CJacobs8/motion-responsive-lightsabre/calculations/Lightsabre_Design_Calculations.pdf

## 1. Concept Selection:

### 1.1 LED Configuration:

L 1 m strip

m

LED N | 60 strip

### LED

1
N 2 strips

N 120 strips N

strip L

strip N
LED

//Total number of LEDs

### 1.2 WS2812B Data Requirement

### B 24 LED

### f 800 kHz data

s

5

### 3 10 fdata

B
LED tLED
//The time required to transmit the data for one LED

### 1.3 Time Required for the Complete LED Strip

### B 2880 LED N

LED B
Total | //The total number of bits transmitted to update all 120 LEDs

0,0036 s
fdata

B
Total tupdate | //The total transmission time
t | 0,05 ms reset | //WS2812B minimum reset (latch) time from the datasheet
t | 3,65 ms reset t

update t
strip | //Complete strip update including the reset time

### 1.4 Required Lighting Update Rate

f | 50 Hz required | //Assumption for the comparison

0,02 s
f
required

1
Trequired

100 18 Trequired

t
update ULED | % | //The percentage of the available update period used by the LED data transmission
t | 0,0164 s update T

required t
remaining

Conclusion: This means the LED data transmission occupies 18% of the 20 ms update period, leaving approximately 16.4 ms for other processing.:

### 1.5 Maximum Theoretical LED Update Rate

### 277,7778 Hz t

update

1
fmax_LED

### 1.6 Concept 1 - Raspberry Pi Pico 2 (RP2350)

### 1.6.1 Microcontroller processing speed:

f | 150 MHz CPU_1

### 4 Oct 2026 18:46:16 - Calcs App E - corrected_5.sm

1 / 15

s

9
6,6667 10 f
CPU_1

1
T
CPU_1

### 1.6.2 Available Processing Cycles per Lighting Update:

6
T 3 10 required f

CPU_1 C

Total_1 | cycles

### 1.6.3 Processing Cycles During LED Transmission:

| 5
t | 5,4 10 update f

CPU_1 C

LED_1 | cycles
| 6 C 2,46 10 LED_1 C
Total_1 C
remaining_1 | cycles

### 1.7 Concept 2 — Arduino Nano

### 1.7.1 Microcontroller Processing Speed:

f | 16 MHz CPU_2

s

8
6,25 10 f
CPU_2

1
T
CPU_2

### 1.7.2 Available Processing Cycles per Lighting Update:

5
T 3,2 10 required f

CPU_2 C

Total_2 | cycles

### 1.7.3 Processing Cycles During LED Transmission:

t | 57600 update f

CPU_2 C

LED_2 | cycles

5
| C 2,624 10 LED_2 C

Total_2 C

remaining_2 | cycles

### 1.8 Concept 3 — ESP32 1.8.1 Microcontroller Processing Speed:

f | 240 MHz CPU_3

s

9
4,1667 10 f
CPU_3

1
T
CPU_3

### 1.8.2 Available Processing Cycles per Lighting Update:

6
T 4,8 10 required f

CPU_3 C

Total_3 | cycles

### 1.8.3 Processing Cycles During LED Transmission:

| 5
t | 8,64 10 update f

CPU_3 C

LED_3 | cycles
| 6 C 3,936 10 LED_3 C
Total_3 C
| remaining_3 | cycles

Conclusion: For the three concepts, the LED requirement is identical because the same 120 WS2812B LEDs are used. The calculated transmission time is therefore 3.60 ms for all three concepts, which is below the 20 ms period associated with the 50 Hz lighting target. The main difference is the processing capacity available around the LED update. The Arduino Nano has approximately 320,000 clock cycles available per update period, compared with 3.00 million for the Pico 2 and 4.80 million for the ESP32.

### 1.9 MPU6050 I²C Data Transfer Time:

N | 12 bytes | //Six 16-bit accelerometer and gyroscope readings
| | 2 / 15

### f 400 kHz I2C

### 0,24 ms fI2C

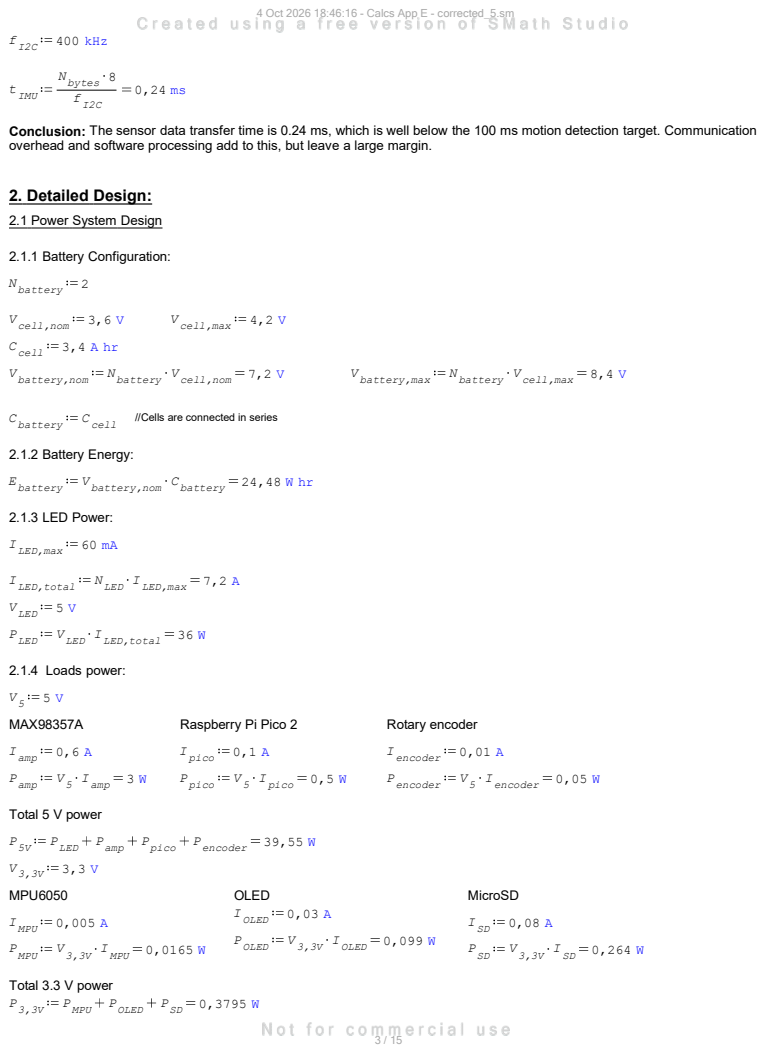
[picture p4: page 3]
N 8 bytes tIMU; 2.1.1 Battery Configuration:; N 2 battery; 3,6 V cell,nom; 4,2 V cell,max; C 3,4 A hr cell; V 7,2 V cell,nom N; battery V; battery,nom; 8,4 V cell,max N; battery V battery,max; cell C battery; 2.1.2 Battery Energy:; C 24,48 W hr battery V; battery,nom E battery; 2.1.3 LED Power:; I 7,2 A LED,max N; LED I LED,total V 5 V LED; I 36 W LED,total V; LED P LED; 2.1.4 Loads power:; MAX98357A; Raspberry Pi Pico 2; Rotary encoder; I 0,6 A amp; 0,1 A pico; 0,01 A encoder; I 3 W amp; amp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

Conclusion: The sensor data transfer time is 0.24 ms, which is well below the 100 ms motion detection target. Communication
overhead and software processing add to this, but leave a large margin.

2. Detailed Design:
2.1 Power System Design

//Cells are connected in series

I 60 mA LED,max

### Total Theoretical System Power

### P 39,9295 W 3,3V P

5V P
total

7,9859 A
V5

P
total I5V,eq
//The theoretical worst-case load exceeds the 5 A rating of the selected buck converter.

0,115 A
V3,3V

P
3,3V I3,3V,req
//Current drawn by the 3.3 V loads (MPU6050, OLED, MicroSD)

### 2.1.5 Power Demand at 58% LED Brightness:

### Buck Converter Rating

I 5 A converter,rated

### I 2,9859 A 5V,eq I

converter,rated I
margin

Conclusion:This means the converter cannot support the theoretical maximum load with all 120 LEDs at full brightness and the brightness needs to be limited in software to overcome this constraint.

Brightness | 0,58
I | Brightness | 4,176 A LED,total I
LED,58

### I 20,88 W LED,58 V

LED P
LED,58

### P 24,8095 W 3,3V P

encoder P

pico P
amp

P

LED,58 P
total,58

4,9619 A
V5

P
total,58 I5V,58

### I 0,0381 A 5V,58 I

converter,rated I
margin,58

Conclusion: 58% is the highest brightness that keeps the theoretical 5 V load within the converter’s 5 A rating, leaving a margin of only about 0.04 A. It is therefore treated as an upper brightness limit set in software. The measured maximum current below (2.91 A, safety factor ≈ 1.72) shows a much larger margin in practice, because not all LEDs run at full white simultaneously.

### Measured Converter Current

I 2,91 A measured,max

I 14,55 W measured,max V
5

P
measured,max
I 2,09 A measured,max I

converter,rated I
margin,measured

1,7182 Imeasured,max

I
converter,rated SFconverter

### Buck Converter Duty Cycle

V | 3 V cell,min | //Li-ion discharge cut-off voltage per cell

V 6 V cell,min N

battery V
battery,min

0,6944 Vbattery,nom

V

### 5 Dnom

0,5952 Vbattery,max

V

### 5 Dfull

//Fully charged battery

4 / 15

0,8333 Vbattery,min

V

### 5 Dempty

//Battery at cut-off

Conclusion: The duty cycle varies between about 60% and 83% over the battery voltage range, which is within the normal operating range of a step-down converter.

### 2.1.6 Battery Calculations:

### Converter Input Power:

η | 0,9 converter
//Assuming a converter efficiency of 90%

44,3661 W
ηconverter

P
total Pin | //For the theoretical maximum load

### P 4,4366 W total P

in P
loss | //Heat produced in the converter at the theoretical maximum load

6,162 A
Vbattery,nom

P
in Ibattery

### Battery C-Rate

### 1,8123 Cbattery

I | hr battery Crate | //Check against the cell's maximum continuous discharge rating

### Cell and BMS Current Rating

I | 8 A cell,dis,max | //Samsung INR18650-35E maximum continuous discharge current (datasheet)

### 1,2983 Ibattery

I
cell,dis,max SFcell
I | 13 A BMS,rated | //HX-2S-D20 continuous current rating

### 2,1097 Ibattery

I
BMS,rated SFBMS

### Usable Battery Capacity

C | 2,72 A hr battery C | 0,8 usable
//Using an 80% usable capacity assumption

### Theoretical Operating Time

### 0,4414 hr Ibattery

C
usable toperating
t | 26,4851 min operating t
operating,min | //The theoretical worst-case operating time at the calculated maximum load

### Operating Time at 58% Brightness

27,5661 W
ηconverter

P
total,58 Pin,58

### P 2,7566 W total,58 P

in,58 P
loss,58

5 / 15

3,8286 A
Vbattery,nom

P
in,58 Ibattery,58

### 1,1261 Cbattery

I hr battery,58 Crate,58

0,7104 hr Ibattery,58

C
usable toperating,58
t | 42,6263 min operating,58 t
operating,58,min

### Operating Time at Measured Load

V | 7,26 V battery,meas | //Measured battery voltage (Table 5.2)
I | 2,47 A battery,meas | //Measured maximum battery current (Table 5.2)

I 17,9322 W battery,meas V

battery,meas P
battery,meas

0,8114 Pbattery,meas

P
measured,max
ηmeasured

//Effective converter efficiency at the measured load

P 3,3822 W measured,max P

battery,meas P
loss,meas | //Converter heat at the measured load

### 0,7265 Cbattery

I hr battery,meas Crate,meas

66,0729 min Ibattery,meas

C
usable toperating,meas

5,2632 Ibattery,meas

I
BMS,rated SFBMS,meas

Conclusion: Using the measured battery current gives a more realistic operating time of about 66 minutes, compared with 26.5 minutes at the theoretical maximum load and 42.6 minutes at the 58% brightness limit. The measured converter efficiency is about 81%, slightly below the assumed 90%.

### 2.1.7 Battery Charging (CN3302):

V 8,4 V charge

I | 2,2 A charge | //CN3302 charging current

### 0,6471 Cbattery

I hr charge Crate,charge

I | 2 A cell,charge,max | //Samsung INR18650-35E maximum charge current (datasheet)

### 0,9091 Icharge

I
cell,charge,max SFcharge

### 1,5455 hr Icharge

C
battery tcharge,CC
//Constant-current stage
k | 1,2 CV | //Allowance for the slower constant-voltage stage

6 / 15

t | 1,8545 hr charge,CC k

CV t
charge

### I 18,48 W charge V

charge P
charge
η | 0,9 charger

### V 5 V USB

4,1067 A
VUSB ηcharger

P
charge Icharger,in

Conclusion: The 2.2 A charging current corresponds to 0.65 C and gives a full charge in about 1.9 h. It is slightly above the 2 A maximum charge current of the cells, so a lower charging current would be preferable for the final design. A 5 V input would need to supply about 4.1 A for the full charging current.

### 2.1.8 Wire Sizing:

m
A

V

8

### 1,68 10 rhoCu

//Resistivity of copper

L | 0,5 m wire | //Conservative one-way cable length
k | 0,05 drop | //Maximum allowable voltage drop of 5%

### Main power connections

V 0,36 V battery,nom k

drop V
drop,power

2
0,2876 mm Vdrop,power

L

wire rhoCu I
battery 2
A
power

2

### A 0,519 mm 20AWG

1,8049 A
power

A
20AWG SFwire,power

### LED strip connections (per strip)

3,6 A
2

I
LED,total Istrip,max
I | Brightness | 2,088 A strip,max I
strip,58

V 0,25 V 5

k

drop V
drop,5V

2

### 0,2419 mm Vdrop,5V

L

wire rhoCu I
strip,max 2
ALED

2

### 0,1403 mm Vdrop,5V

L

wire rhoCu I
strip,58 2
ALED,58

//Compare with the cross-sectional area of the LED strip power leads (e.g. 22 AWG = 0.326 mm², 20 AWG = 0.519 mm²).

### Microcontroller connections

### V 0,165 V 3,3V k

drop V
drop,3,3V

7 / 15

2

### 0,0102 mm Vdrop,3,3V

L

wire rhoCu I
pico 2
AMCU

2

### A 0,326 mm 22AWG

### Speaker and amplifier connections

P 3 W speaker

A

### 4 V

Rspeaker | //4 Ω speaker

0,866 A
Rspeaker

P
speaker Ispeaker

2

### 0,0582 mm Vdrop,5V

L

wire rhoCu I
speaker 2
Aspeaker

2

### A 0,129 mm 26AWG

Conclusion: All selected wires have a larger cross-sectional area than required for a 5% voltage drop. The main power wire (20 AWG) has an area 1.8 times the required value.

### 2.1.9 Connector and Terminal Current Checks:

I | 3 A JST,rated | //JST-XH 2.54 mm rated current

0,8333 Istrip,max

I
JST,rated SFJST,max
//Full white brightness

1,4368 Istrip,58

I
JST,rated SFJST,58
//58% brightness limit
I | 10 A terminal,rated | //Screw terminal block rating - confirm against the datasheet of the terminals used

### 1,6229 Ibattery

I
terminal,rated SFterminal

Conclusion: At full white brightness each strip would draw 3.6 A, which exceeds the 3 A JST-XH rating. With the brightness limited to 58% in software the strip current is 2.09 A, giving a safety factor of 1.44. The screw terminals carry the maximum battery current with a safety factor of 1.62.

### 2.2 Mechanical Design:

### 2.2.1 Design Assumptions and Physical Dimensions: Hilt

2
s

m
g 9,81
3
cm

g
rho | 1,27 PETG L | 250 mm hilt

3
V | 347,22 cm hilt | Infill | 0,7
rho | Infill | 0,3087 kg PETG V

hilt m
hilt

### m g 3,0281 N hilt W

hilt

### Blade Geometry

L | 920 mm blade | D | 25,4 mm o

8 / 15

3
cm

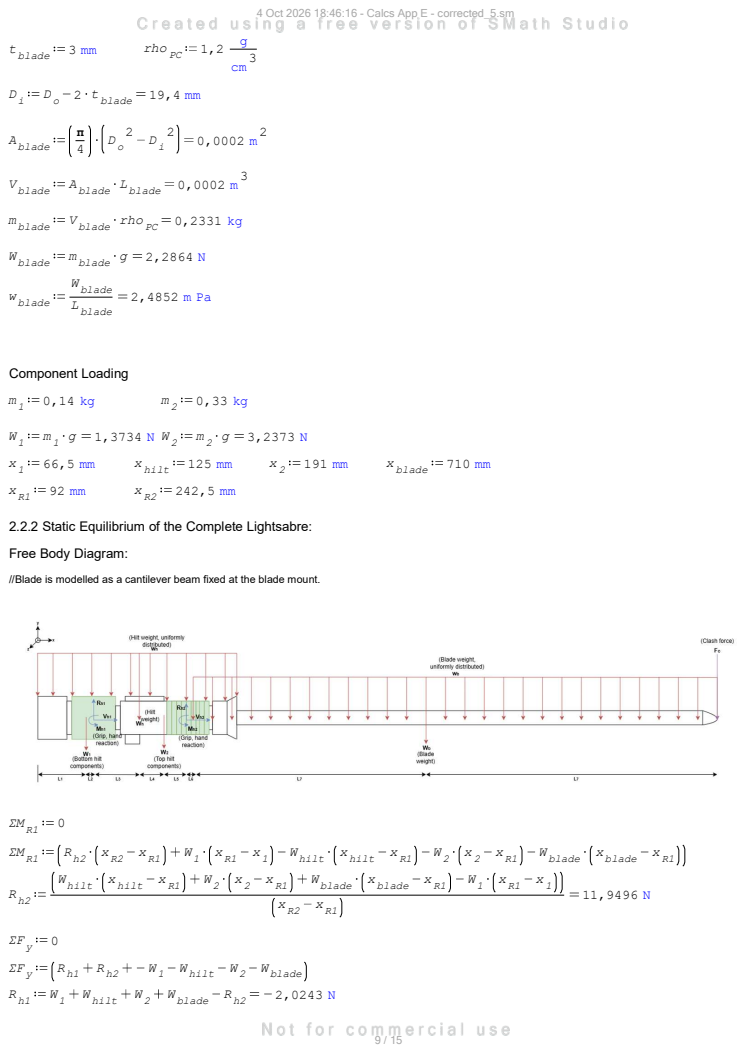
[picture p5: page 9]
rho; 3 mm blade; 19,4 mm blade D; blade; L 0,0002 m blade A; blade V blade; blade m blade; g 2,2864 N blade W; 2,4852 m Pa Lblade; W blade wblade; Component Loading; 125 mm hilt; 710 mm blade; blade W; blade x; hilt W; hilt x 1; h2 ΣMR1; hilt W hilt; blade W 2; hilt W 1

2.2.2 Static Equilibrium of the Complete Lightsabre:
Free Body Diagram:

//Blade is modelled as a cantilever beam fixed at the blade mount.

//R.h1 is negative, so the rear hand pushes downward on the hilt while the front hand carries the full weight plus the moment from the overhanging blade.

### Selection of the Clash Load

### F 50 N c

5,0968 kg
g

F
c mc

### 21,8682 Wblade

F
c Fratio

Conclusion: The clash force was not measured experimentally, so a 50 N transverse force was assumed for the structural analysis. This represents a severe impact condition and is approximately 21.8 times the blade weight, providing a conservative basis for the stress and deflection calculations.

### 2.2.3 Blade Loading Cases:

//The blade is assessed under two loading conditions. Static loading represents the blade's own weight, while the clash case represents a transverse impact at the blade tip. The clash case is used as the main structural design condition.

### Static loading

### L 2,2864 N blade w

blade V
static

1,0518 N m
2

2
L
blade w
blade M
static

### Clash loading

//Clash force acts transversely at the blade tip.

### W 52,2864 N blade F

c

V
clash

### M 47,0518 N m static L

blade F
c

M
clash

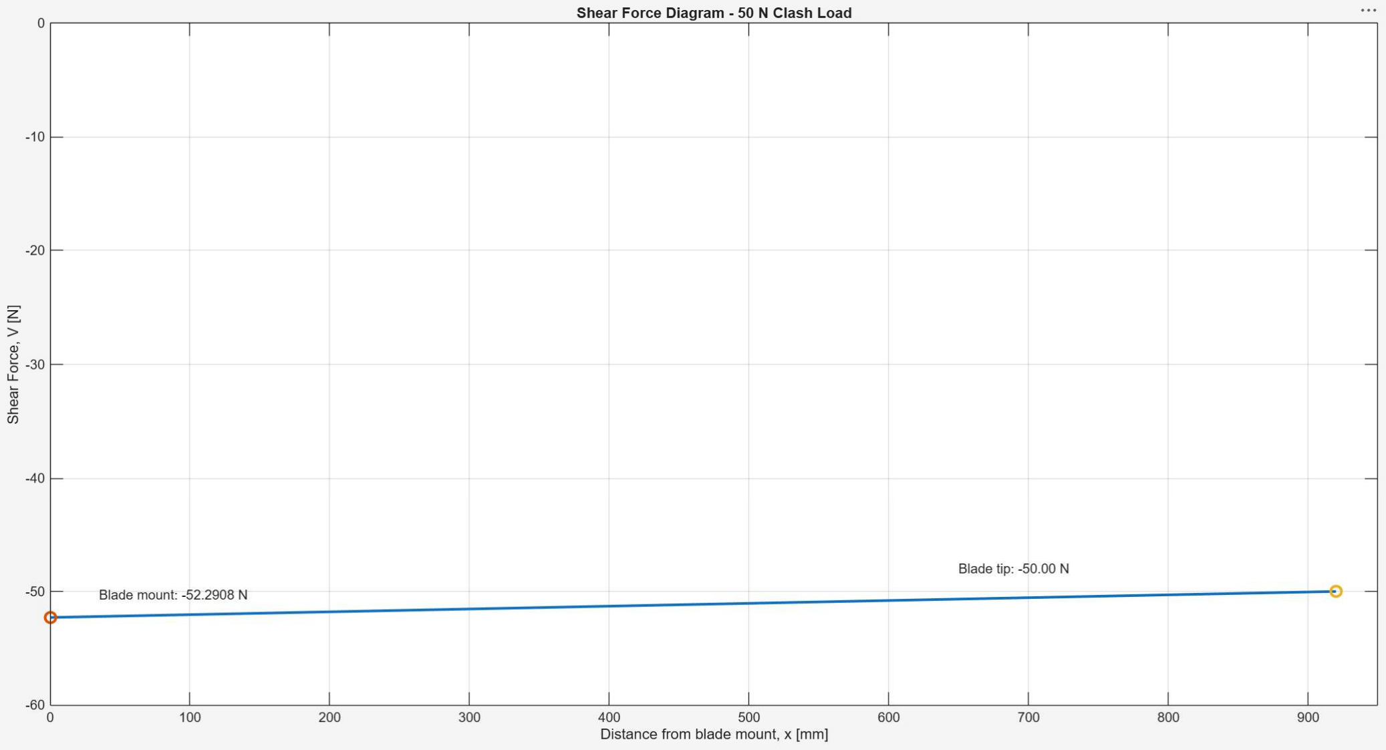
[picture p6: figure]

### 2.2.4 Shear Force Diagram:

//x = 0 at the blade mount and x = L_blade at the blade tip.

L x

blade w

blade F
c

V x

V | V 0 | 52,2864 N mount
V L | 50 N blade V
tip

### 2.2.5 Bending Moment Diagram:

2

2
L x
blade
w
blade L | x

blade F
c

M x

10 / 15

M | M 0 | 47,0518 N m mount
M L | 0 N m blade M
tip

### 2.2.6 Bending Stress:

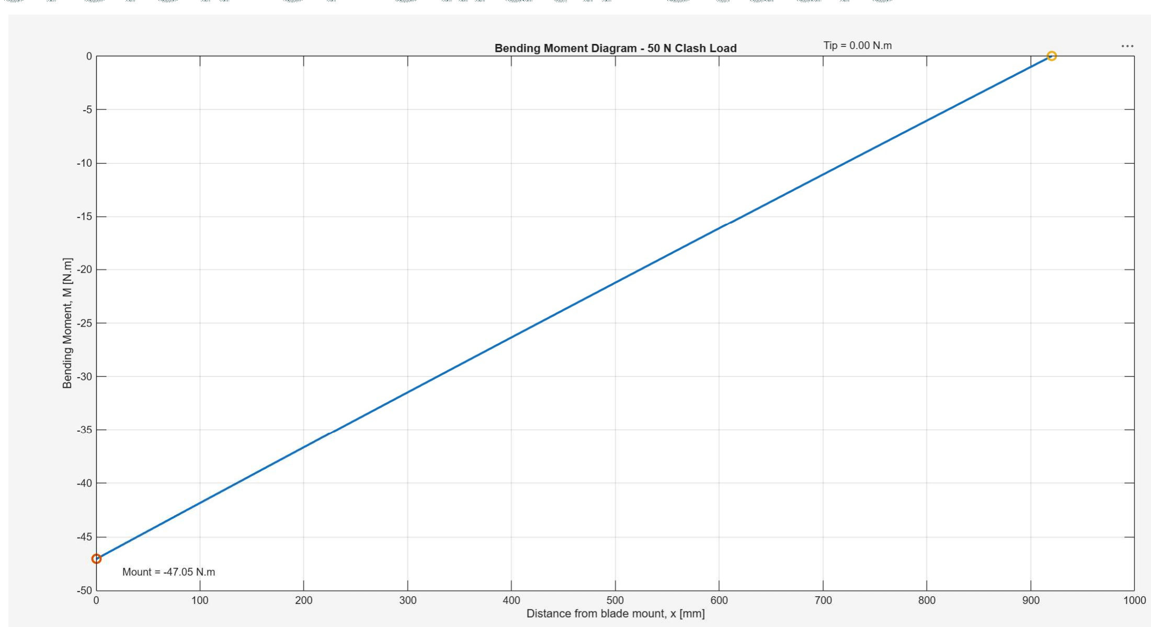
[picture p7: figure]

// Maximum bending stress occurs at the blade mount. Linear elastic beam theory is used.

### M 47,0518 N m mount M

max

4
m

8
1,3479 10

4
D
i

4
D

### 64 o

π
I

0,0127 m
2

D
o c

### 44,3337 MPa I

M c
max σmax

### 0,991 MPa I

M c
static σstatic
//Bending stress under the blade self-weight only

### 2.2.7 Transverse Shear Stress:

### V 52,2864 N mount V

max

12,7 mm
2

D
o Ro | 9,7 mm
2

D
i Ri

3
m

7
7,5714 10

3
R
i

3
R

### 3 o

2
Q // First moment of area at the neutral axis

### R 6 mm i

R
o
b | 2 | // Width of hollow section at neutral axis

### 0,4895 MPa

I b

Q
Vmax

τmax

### 2.2.8 Stress Safety Factor:

// A preliminary polycarbonate yield strength of 60 MPa is used for the structural assessment.

### σ 60 MPa

y

1,3534

| σmax σ

### y FS

### 2.2.9 Blade Deflection:

// Elastic modulus is assumed as 2.3 GPa for the polycarbonate.

11 / 15

### E 2,3 GPa

418,6377 mm

### 3 E I

3
L
blade F
c

δ
clash

### 0,455 Lblade

δ
clash δratio

7,1789 mm

### 8 E I

4
L

blade w
blade δ
static

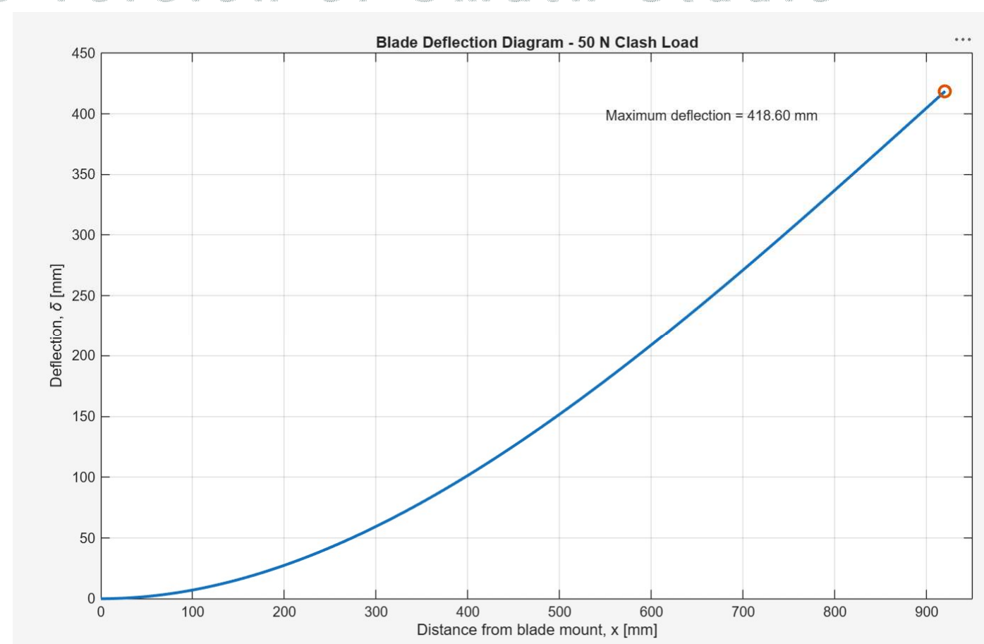
[picture p8: figure]

//Tip deflection under the blade self-weight

δ | 425,8166 mm static δ

clash δ
total

Conclusion: The calculated tip deflection under the clash load is about 45% of the blade length, which is outside the small-deflection range for which the cantilever formula is valid, so the value is only indicative. It shows that a 50 N static tip load would bend the blade severely. In practice a clash is a short impact rather than a sustained static load, but blade stiffness (wall thickness or material) should be reviewed.

### 2.2.10 Blade Mount Epoxy Bond:

//Blade engagement inside the mount is taken as 80 mm. Epoxy is assumed to form a continuous cylindrical bond around the blade over the 80 mm engagement.

### D 0,0254 m blade

### L 0,08 m mount

0,0127 m
2

D
blade Rblade

2

### L 0,0064 m mount D

blade A | π bond

### Direct shear in epoxy

### 0,0082 MPa Abond

V
mount τdirect

### M 47,0518 N m mount M

mount_load

### 1,1607 MPa

Lmount

2
Rblade π

M
mount_load τmoment

### 1,1608 MPa

2
τ
moment

2
τ

direct τ
epoxy

### Epoxy Strength

// Bostik Super Epoxy TDS (2025) gives a bulk tensile strength of 50 MPa. A conservative allowable bond stress of 2 MPa is

12 / 15

τ | 2 MPa | used because adhesion to PETG and polycarbonate governs the joint strength. allowable

1,723
τepoxy

τ
allowable FS
epoxy

### Blade Mount Flange (Lip) Bond to the Hilt

//The PETG blade mount sits on the top of the hilt and is bonded with epoxy on the lip (flange) at its base. The bond is modelled as an annulus between the Ø25 mm mount bore and the Ø53 mm top of the hilt, carrying the clash moment and shear at the mount.

### D 53 mm lip,o

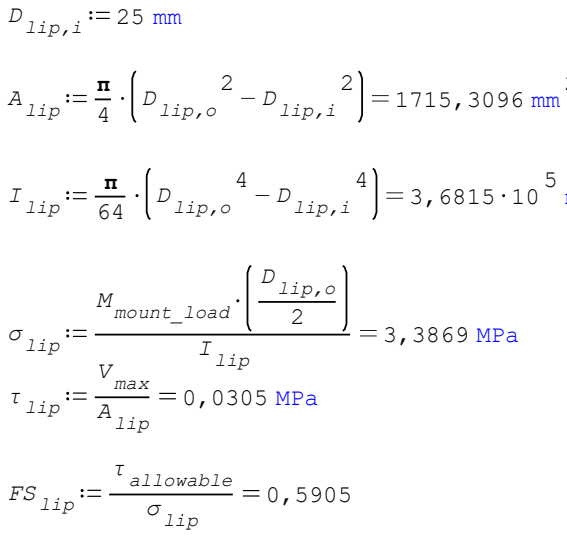
[picture p9: figure]
D 25 mm lip,i; lip,i; D 4 lip,o; lip; D 64 lip,o; 3,3869 MPa Ilip; D lip,o Mmount_load; 0,0305 MPa Alip; V max τlip; σlip; τ allowable FSlip

2

4
mm

//Tensile (peel) stress at the edge of the bond

//Using the 2 MPa tensile strength of the epoxy

29,0576 N
L
blade

Mstatic

2

Dlip,o

I

lip τ
allowable

Fc,allow

//Tip force at which the lip bond reaches its strength

Conclusion: The lip bond has a factor of safety of 0.59 under the assumed 50 N clash load, so it is the weakest part of the blade connection. The bond reaches its strength at a tip force of about 29 N. Light clashes are therefore acceptable, but heavy duelling impacts could separate the blade mount from the hilt. A longer spigot into the hilt or a mechanical fastener would increase the strength.

## 2.3 Thermal Design:

### 2.3.1 LED Heat Dissipation:

η | 0,2 LED,light | //Assumed fraction of LED power converted to light

### P 10,6205 W 3,3V P

encoder P

pico P
amp

P

measured,max P
LED,meas | //Approximate LED power at the measured load

### P 16,704 W LED,58 η

LED,light Q | 1 LED,58

### P 8,4964 W LED,meas η

LED,light Q | 1 LED,meas

2

### L 0,0734 m blade D

o

A π blade,surf

K

2
m

### 10 W

hconv
//Natural convection heat transfer coefficient for still air

13 / 15

22,7535 K
Ablade,surf hconv

Q
LED,58 ΔTblade,58

11,5735 K
Ablade,surf hconv

Q
LED,meas ΔTblade,meas

Conclusion: The blade surface temperature rise is about 23 K at the 58% brightness limit and about 12 K at the measured load. With a 25 °C ambient this gives a maximum of about 48 °C, below the 80 °C maximum operating temperature of the WS2812B, so the aluminium heat-sink rod is not required.

### 2.3.2 Hilt Vents:

N 2 vent

w | 2 mm vent
L | 37 mm vent | //Two through-slots in the top section of the hilt

2

### L 148 mm vent w

vent N

vent A
vent

### P 3,3822 W loss,meas Q

conv | //Heat produced by the buck converter at the measured load

3
m

### 1,2 kg rhoair

### kg K

1005 J
cpair

s

0,2 m
vair | | //Assumed natural convection air velocity through the vents
ΔT | 10 K air | //Allowed air temperature rise
ΔT | 0,357 W air A

vent v

air cpair rhoair Q
vent

### 0,1055 Qconv

Q
vent Qvent,fraction

### Remaining heat through the hilt wall

### D 53 mm hilt

t | 3 mm wall

m K

0,2 W
kPETG

2

### L 0,0416 m hilt D

hilt A | π hilt

W

K
0,3604
Ahilt kPETG

t
wall Rwall

W

K
2,4023
A

hilt h
conv

1
Rsurf

### R 8,3578 K surf R

wall Q

vent Q
conv

ΔThilt

Conclusion: The two vents remove about 0.36 W, roughly 11% of the 3.4 W produced by the converter at the measured load. The remaining heat passes through the hilt wall, giving an estimated internal temperature rise of about 8 K above ambient. The vents therefore assist the cooling, while the heatsink and hilt surface carry most of the heat. The measured temperatures in

14 / 15

Table 5.3 verify this.

15 / 15
