CJacobs8/motion-responsive-lightsabre/results/fig_mean_spectrum.pdf

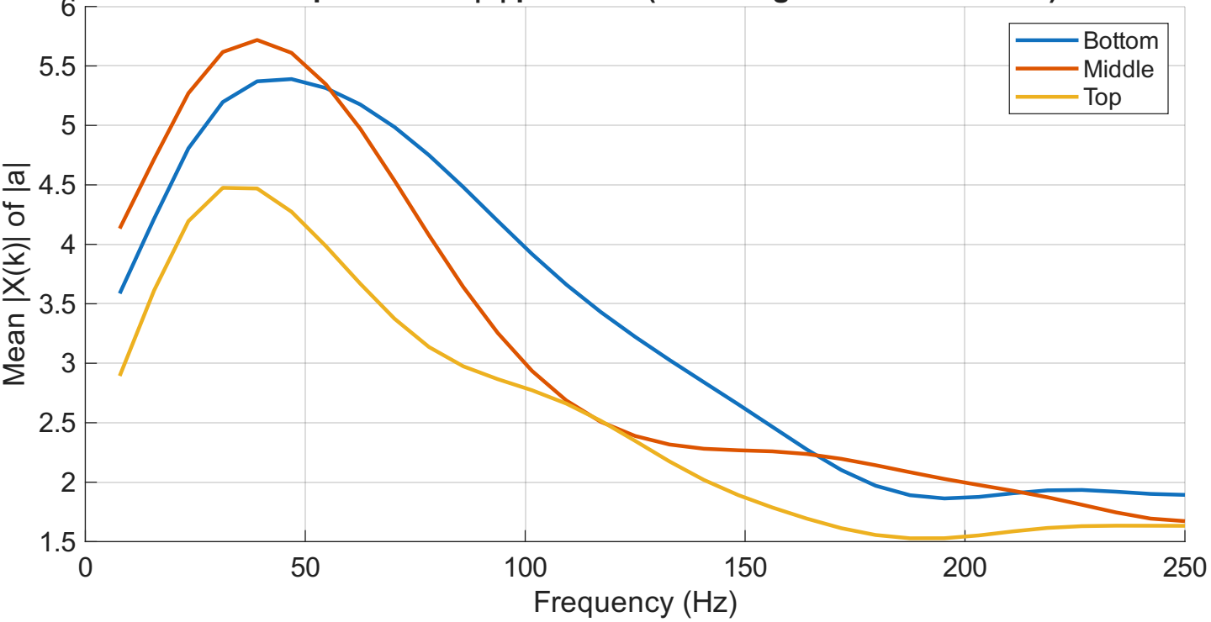
[picture p10: figure]
Frequency (Hz); Bottom Middle; Top

6 | Mean spectrum of |a| per zone (Hamming-windowed frames)
