CJacobs8/motion-responsive-lightsabre/results/fig_mean_spectrum.png

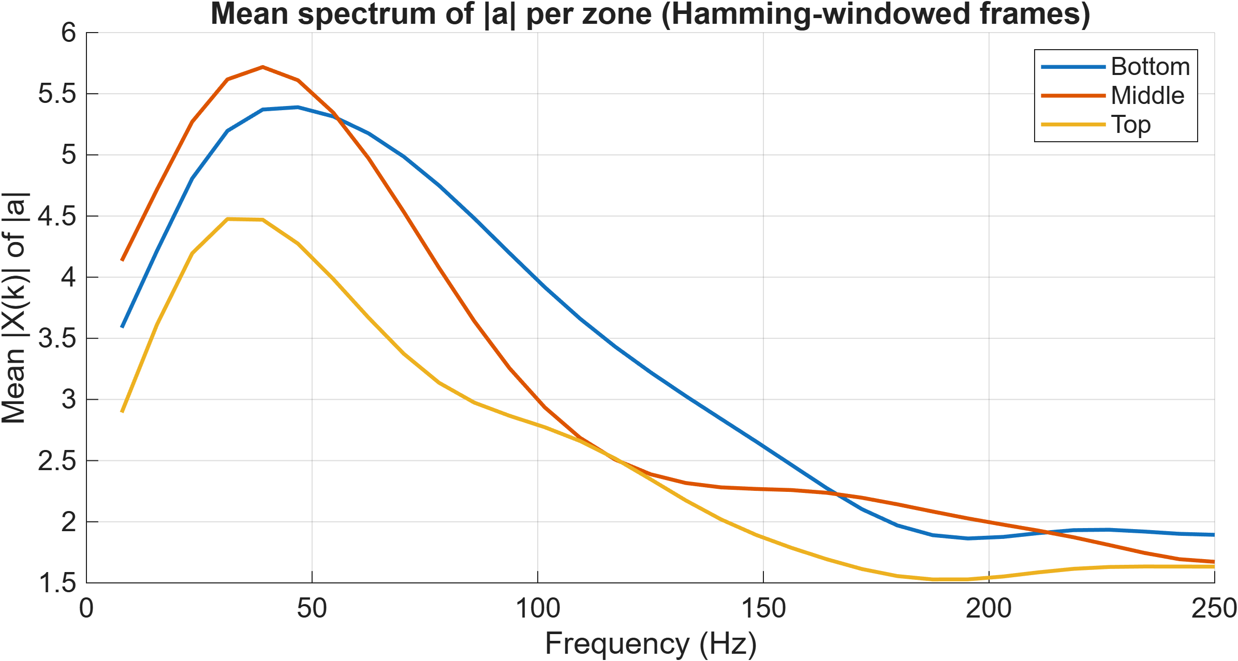
results/fig_mean_spectrum.png
