CJacobs8/motion-responsive-lightsabre/data/tpm_tests/TPM_01_activation_time/TPM_01_activation_time.csv

trial | press_to_first_led_ms | delay_after_800ms_hold_ms | met_target_1000ms | note
1 | 1592.8 | 792.8 | no | first ignition after power-up
2 | 913.6 | 113.6 | yes
3 | 820.6 | 20.6 | yes
4 | 809.0 | 9.0 | yes
5 | 869.5 | 69.5 | yes
6 | 917.5 | 117.5 | yes
7 | 816.4 | 16.4 | yes
8 | 956.6 | 156.6 | yes
9 | 809.1 | 9.1 | yes
10 | 927.5 | 127.5 | yes
