CJacobs8/motion-responsive-lightsabre/data/tpm_tests/TPM_01_activation_time/TPM_01_activation_time.xlsx

TPM_01: Activation time test
Time from pressing the encoder button to the first ignition LED frame, logged by the firmware (TIMING_TEST = 1, micros() timer), 10 trials.
Legend: yellow = measured values (from the Serial Monitor) | blue = settings | other cells calculate automatically.
Settings
Target (ms) | 1000 | TPM_01: activation time <= 1 s
Long-press hold time (ms) | 800 | LONG_PRESS_TIME in Lightsaber_Main.ino
Date tested | 2026-10-11
Firmware | Lightsaber_Main.ino with TIMING_TEST = 1
Measurements
Trial | Press -> first LED (ms) | Delay after hold (ms) | Met (<= target) | Notes
1 | 1592.8 | 792.8 | No | First ignition after power-up
2 | 913.6 | 113.6 | Yes
3 | 820.6 | 20.6 | Yes
4 | 809.0 | 9.0 | Yes
5 | 869.5 | 69.5 | Yes
6 | 917.5 | 117.5 | Yes
7 | 816.4 | 16.4 | Yes
8 | 956.6 | 156.6 | Yes
9 | 809.1 | 9.1 | Yes
10 | 927.5 | 127.5 | Yes
Summary (copy into Table H4)
Trials | 10
Mean (ms) | 943.3
Min (ms) | 809.0
Max (ms) | 1592.8
Standard deviation (ms) | 234.9
Trials meeting target | 9 / 10
Met (all trials <= target) | No
Mean excluding trial 1 (ms) | 871.1
Max excluding trial 1 (ms) | 956.6
