CJacobs8/motion-responsive-lightsabre/data/tpm_tests/TPM_03_motion_response_time/TPM_03_motion_response_time.xlsx

TPM_03: Motion detection response time
Time from the raw gyro rate first exceeding the swing threshold to the swing state being set, logged by the firmware (TIMING_TEST = 3, micros() timer).
Legend: yellow = measured values (from the Serial Monitor) | blue = settings | other cells calculate automatically.
Settings
Target (ms) | 100 | TPM_03: response time <= 100 ms
Swing threshold (deg/s) | 1.8 | swingStartThreshold (Medium)
Gyro read interval (ms) | 3 | updateMotion() every 3 ms; timing uncertainty about +/-3 ms
Date tested | 2026-10-11
Measurements
Swing | Onset -> swing state (ms) | Met (<= target) | Notes
1 | 50.9 | Yes
2 | 46.3 | Yes
3 | 73.4 | Yes
4 | 19.4 | Yes
5 | 12.2 | Yes
6 | 53.8 | Yes
7 | 41.6 | Yes
8 | 39.8 | Yes
9 | 116.3 | No
10 | 86.0 | Yes
11 | 92.8 | Yes
12 | 93.1 | Yes
13 | 81.1 | Yes
14 | 104.6 | No
15 | 64.8 | Yes
16 | 62.5 | Yes
17 | 0.2 | Yes | Onset and swing state in the same gyro read (fast start)
18 | 74.5 | Yes
19 | 28.6 | Yes
20 | 58.5 | Yes
Summary (copy into Table H6)
Swings | 20
Mean (ms) | 60.0
Median (ms) | 60.5
Min (ms) | 0.2
Max (ms) | 116.3
Standard deviation (ms) | 31.1
Swings meeting target | 18 / 20
Met (all swings <= target) | No
