CJacobs8/motion-responsive-lightsabre/results/fig_confidence_test.pdf

Highest class probability

0.3 | 0.4 | 0.5 | 0.6 | 0.7 | 0.8 | 0.9 | 1

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
25 | Prediction confidence on the independent test

correct
incorrect
