CJacobs8/motion-responsive-lightsabre/results/fig_confusion_cv.pdf

Bottom | Middle | Top
| Predicted Class

Bottom

Middle

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
Cross-validation (leave-one-session-out): 85.4 %

158 | 7 | 15
11 | 137 | 28
5 | 12 | 161
