CJacobs8/motion-responsive-lightsabre/results/fig_confusion_test.pdf

Bottom | Middle | Top
| Predicted Class

Bottom

Middle

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
Independent test: 97.2 %

1

1

24

22

23
