CJacobs8/motion-responsive-lightsabre/results/fig_feature_importance.pdf

M

o

s

t in

flu

e

n

tial fe

a

t

u

r

e

s ||w|| across classes (standardised f

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
