CJacobs8/motion-responsive-lightsabre/data/live_test/live_test_log.xlsx

Sheet: Live Test
Clash Classifier – Live Test (horizontal and vertical)
Clash # | Orientation | Zone struck | Strength | Zone shown | Correct (Y/N)
1 | Horizontal | Top | Light | Top | Y
2 | Horizontal | Bottom | Medium | Bottom | Y
3 | Horizontal | Bottom | Light | Bottom | Y
4 | Horizontal | Middle | Light | Middle | Y
5 | Horizontal | Middle | Medium | Middle | Y
7 | Horizontal | Middle | Medium | Middle | Y
8 | Horizontal | Top | Medium | Bottom | N
9 | Horizontal | Middle | Light | Middle | N
10 | Horizontal | Bottom | Light | Bottom | Y
11 | Horizontal | Bottom | Medium | Bottom | Y
12 | Horizontal | Top | Hard | Top | Y
13 | Horizontal | Bottom | Medium | Bottom | Y
14 | Horizontal | Bottom | Hard | Bottom | Y
15 | Horizontal | Middle | Medium | Middle | Y
16 | Horizontal | Top | Hard | Top | Y
17 | Horizontal | Middle | Light | Middle | Y
18 | Horizontal | Bottom | Hard | Bottom | Y
19 | Horizontal | Top | Light | Top | Y
20 | Horizontal | Middle | Hard | Middle | Y
21 | Horizontal | Middle | Hard | Middle | Y
22 | Horizontal | Top | Light | Top | Y
23 | Horizontal | Bottom | Light | Bottom | Y
24 | Horizontal | Top | Medium | Top | Y
25 | Horizontal | Top | Medium | Top | Y
26 | Horizontal | Top | Medium | Top | Y
27 | Horizontal | Top | Light | Top | Y
28 | Horizontal | Top | Hard | Top | Y
29 | Horizontal | Bottom | Medium | Bottom | Y
30 | Horizontal | Middle | Hard | Middle | Y
31 | Vertical | Top | Hard | Top | Y
32 | Vertical | Middle | Hard | Middle | Y
33 | Vertical | Bottom | Light | Bottom | Y
34 | Vertical | Bottom | Medium | Bottom | Y
35 | Vertical | Bottom | Hard | Bottom | Y
36 | Vertical | Top | Hard | Top | Y
37 | Vertical | Middle | Light | Middle | Y
38 | Vertical | Middle | Medium | Middle | Y
39 | Vertical | Middle | Light | Middle | Y
40 | Vertical | Top | Medium | Top | Y
41 | Vertical | Bottom | Light | Bottom | Y
42 | Vertical | Middle | Light | Bottom | N
43 | Vertical | Top | Light | Middle | N
44 | Vertical | Middle | Medium | Middle | Y
45 | Vertical | Middle | Medium | Middle | Y
46 | Vertical | Middle | Hard | Middle | Y
47 | Vertical | Middle | Medium | Middle | Y
48 | Vertical | Top | Light | Top | Y
49 | Vertical | Bottom | Hard | Bottom | Y
50 | Vertical | Bottom | Medium | Bottom | Y
51 | Vertical | Middle | Hard | Middle | Y
52 | Vertical | Bottom | Light | Bottom | Y
53 | Vertical | Bottom | Medium | Bottom | Y
54 | Vertical | Top | Medium | Top | Y
55 | Vertical | Top | Light | Middle | N
56 | Vertical | Top | Medium | Top | Y
57 | Vertical | Bottom | Medium | Bottom | Y
58 | Vertical | Bottom | Hard | Bottom | Y
59 | Vertical | Top | Medium | Top | Y
60 | Vertical | Top | Hard | Top | Y

Sheet: Summary
Live Test Results
Calculated from the Live Test sheet – nothing to fill in here.
Table for the report
Orientation | Clashes | Correct | Accuracy | 95% CI low | 95% CI high | Not detected | Detection rate
Horizontal | 29 | 27 | 93.1% | 78.0% | 98.1% | #REF! | #REF!
Vertical | 30 | 27 | 90.0% | 74.4% | 96.5% | #REF! | #REF!
Total | 59 | 54 | 91.5% | 81.6% | 96.3% | #REF! | #REF!
Accuracy per zone
Zone struck | Horizontal | Vertical | Total
Bottom | 100.0% | 100.0% | 100.0%
Middle | 88.9% | 90.0% | 89.5%
Top | 90.9% | 80.0% | 85.7%
Accuracy per strength
Strength | Clashes | Correct | Accuracy
Light | 19 | 15 | 78.9%
Medium | 23 | 22 | 95.7%
Hard | 17 | 17 | 100.0%
Confusion matrix – Horizontal (needs "Zone shown on blade")
Struck \ Shown | Bottom | Middle | Top | None
Bottom | 9 | 0 | 0 | 0
Middle | 0 | 9 | 0 | 0
Top | 1 | 0 | 10 | 0
Confusion matrix – Vertical (needs "Zone shown on blade")
Struck \ Shown | Bottom | Middle | Top | None
Bottom | 10 | 0 | 0 | 0
Middle | 1 | 9 | 0 | 0
Top | 0 | 2 | 8 | 0
Rows to check (Y/N disagrees with zone shown) | #REF!
