CJacobs8/motion-responsive-lightsabre/results/fig_confidence_test.png

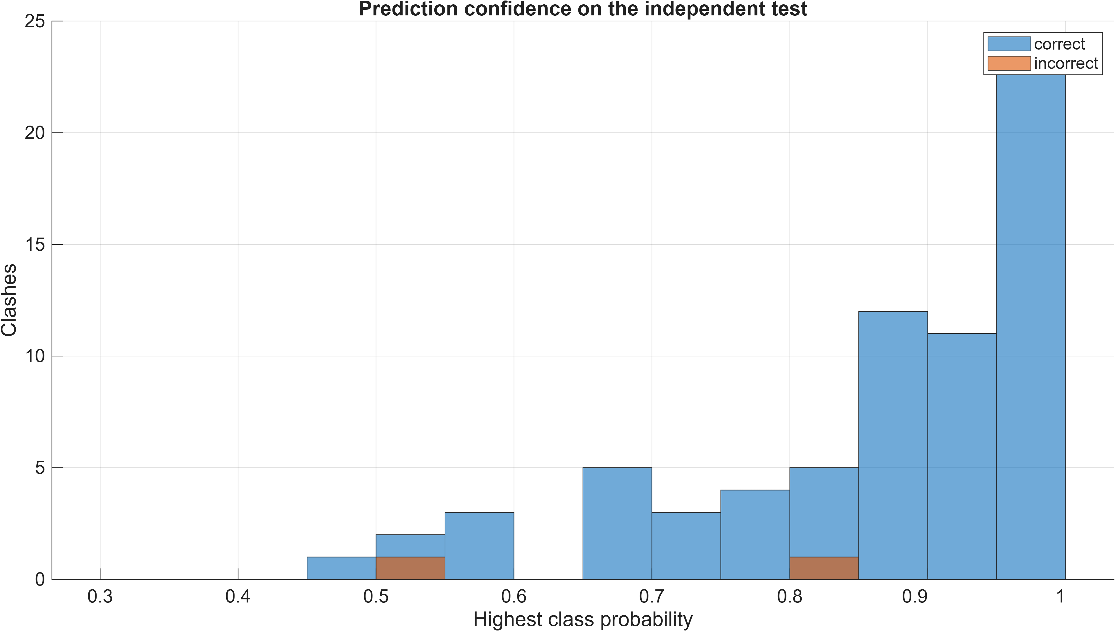
results/fig_confidence_test.png
