CJacobs8/motion-responsive-lightsabre/results/fig_confusion_cv.png

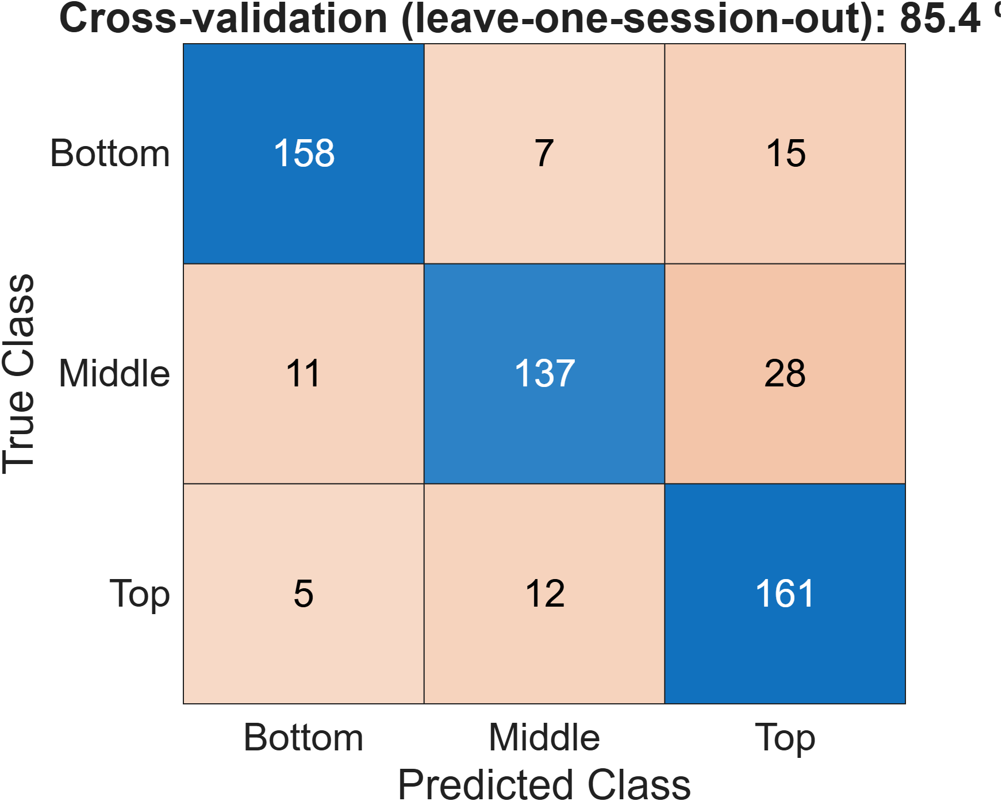
results/fig_confusion_cv.png
