CJacobs8/motion-responsive-lightsabre/results/fig_confusion_test.png

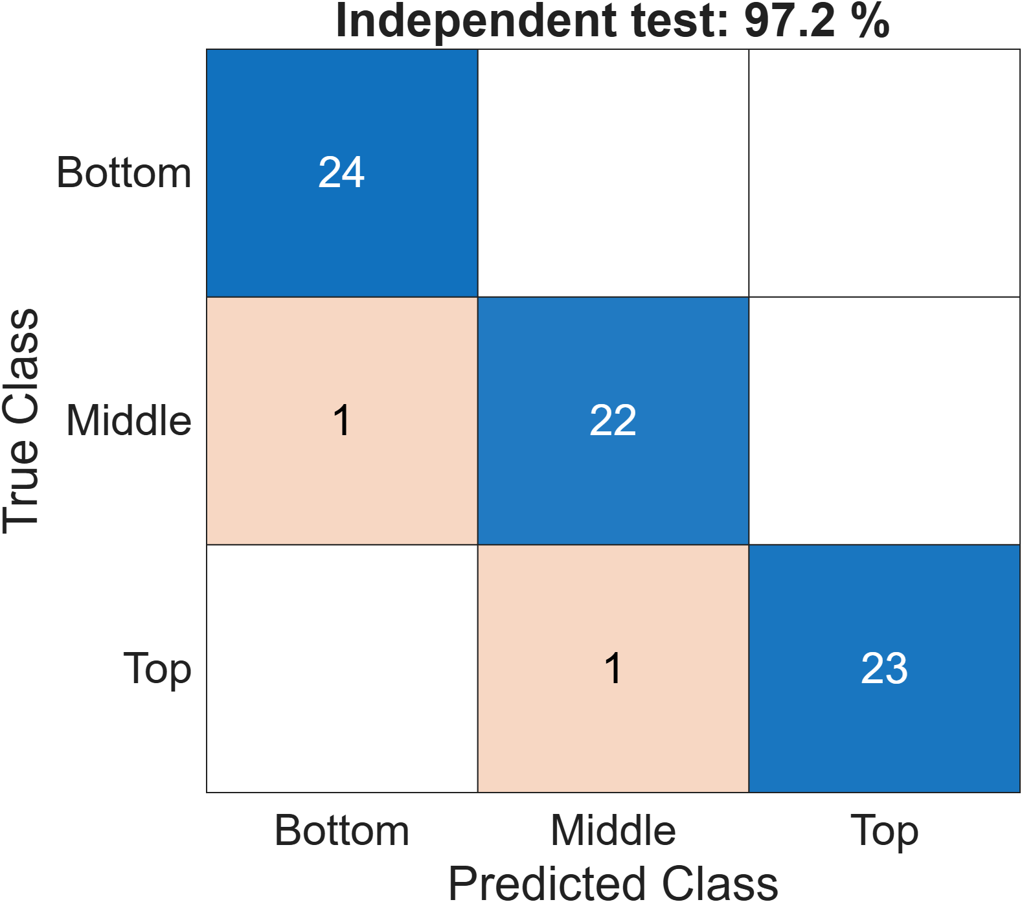
results/fig_confusion_test.png
