CJacobs8/motion-responsive-lightsabre/results/fig_feature_importance.png

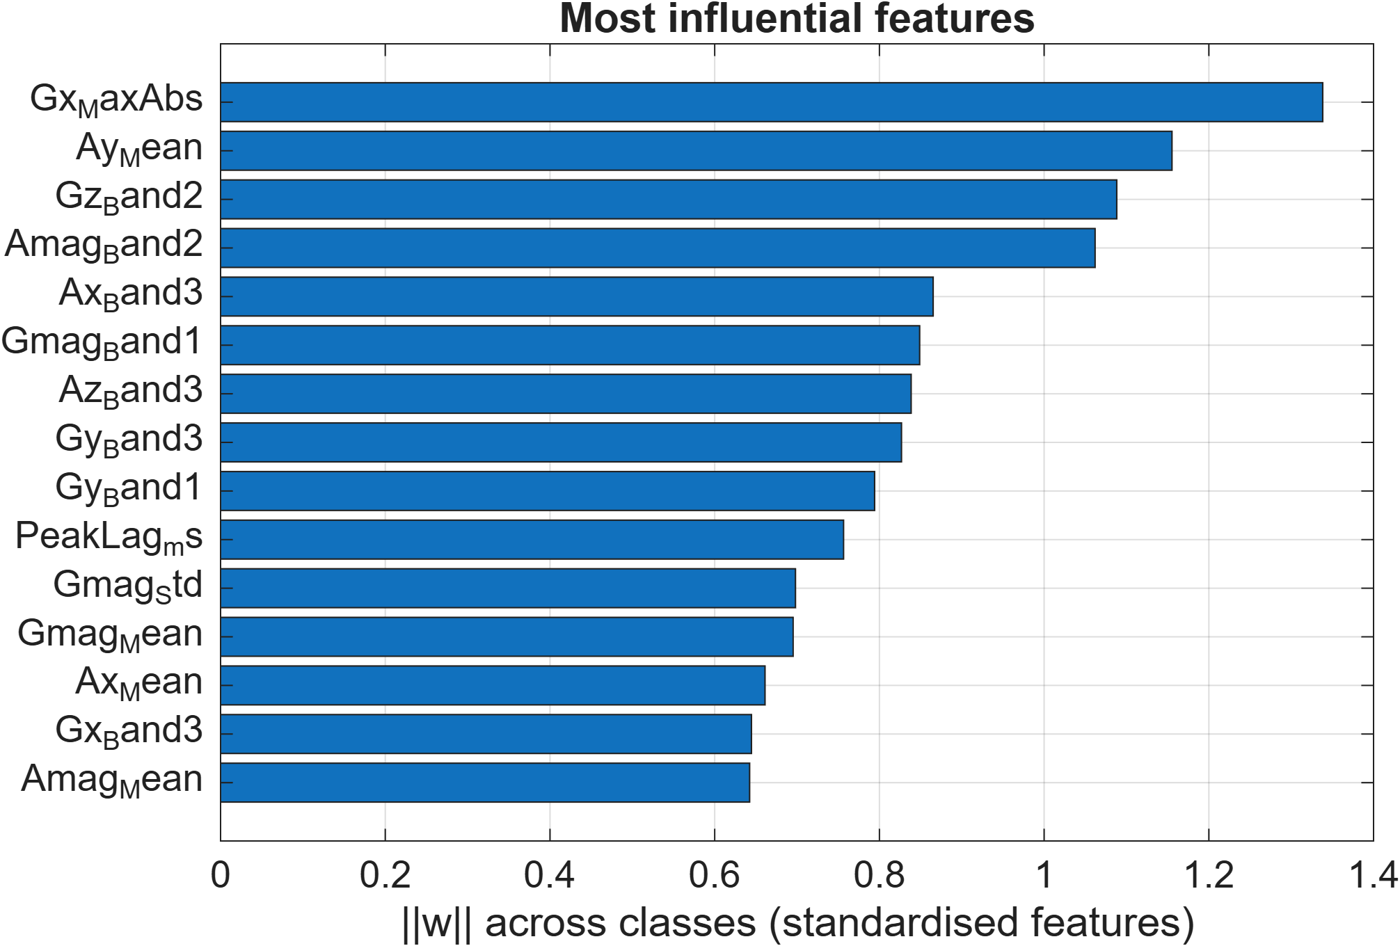
results/fig_feature_importance.png
