CJacobs8/motion-responsive-lightsabre/results/fig_window_sweep.pdf

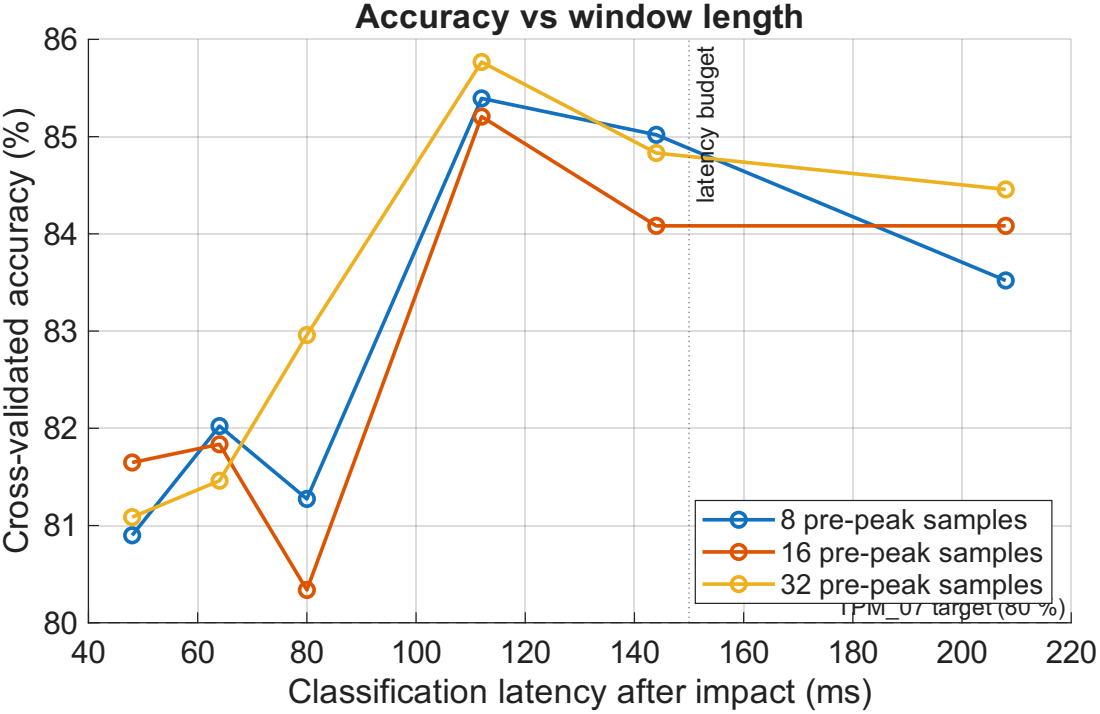
[picture p18: page 1]
Cro; alid; ate; ura; Accuracy vs window length; latenc; y budg

8 pre-peak samples
16 pre-peak samples 32 pre-peak samples TPM_07 target (80 %)

Classification latency after impact (ms)
