CJacobs8/motion-responsive-lightsabre/results/fig_mean_response.pdf

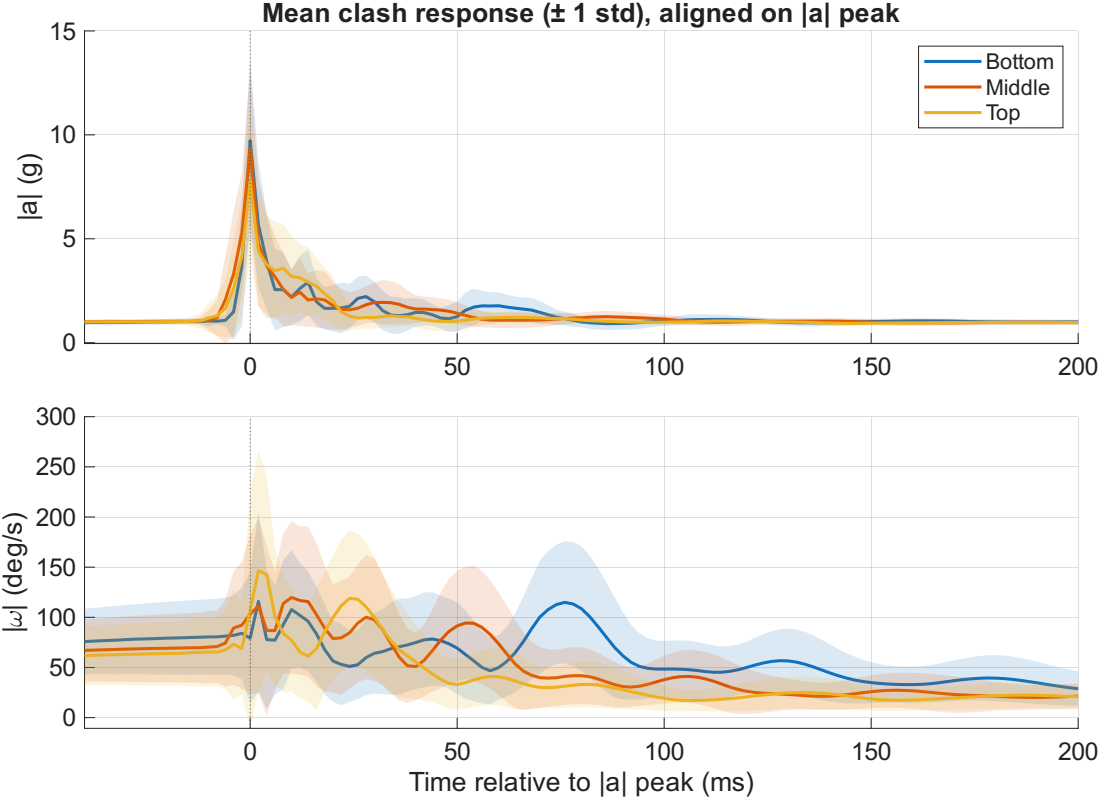
[picture p19: page 1]
Mean clash response (± 1 std), aligned on |a| peak; Bottom Middle Top

Time relative to |a| peak (ms)
