CJacobs8/motion-responsive-lightsabre/(commit log)

2026-10-11 "Add TPM_01 activation time data"
    [TPM_01_activation_time.csv, TPM_01_activation_time.xlsx]
2026-10-11 Add TPM_03 motion detection response time data and swing demo
    [TPM_03_motion_response_time.csv, TPM_03_motion_response_time.xlsx]
2026-10-11 Add TPM_05 motion audio response time data and slow-motion demo
    [TPM_05_motion_audio_response_time.csv, TPM_05_motion_audio_response_time.xlsx]
2026-10-11 Add TPM_06 and TPM_08 clash response data
    [TPM_06_clash_detection_response_time.csv, TPM_06_clash_detection_response_time.xlsx, TPM_08_clash_response_time.csv, TPM_08_clash_response_time.xlsx]
2026-10-11 Add TPM_10 deactivation time data and retraction demo
    [TPM_10_deactivation_time.csv, TPM_10_deactivation_time.xlsx]
2026-10-13 Add TPM_09 summary and predicted discharge curve
    [TPM_09_predicted_discharge.csv]
2026-10-15 Replace TPM_09 with measured discharge test
    [TPM_09_continuous_operating_time.csv, TPM_09_continuous_operating_time.xlsx, TPM_09_predicted_discharge.csv]
